bartlomiej-pluta/binary-clock/kicad/Binary Clock.kicad_pcb

## KiCad design kicad/Binary Clock.kicad_pcb (2020-12-05)

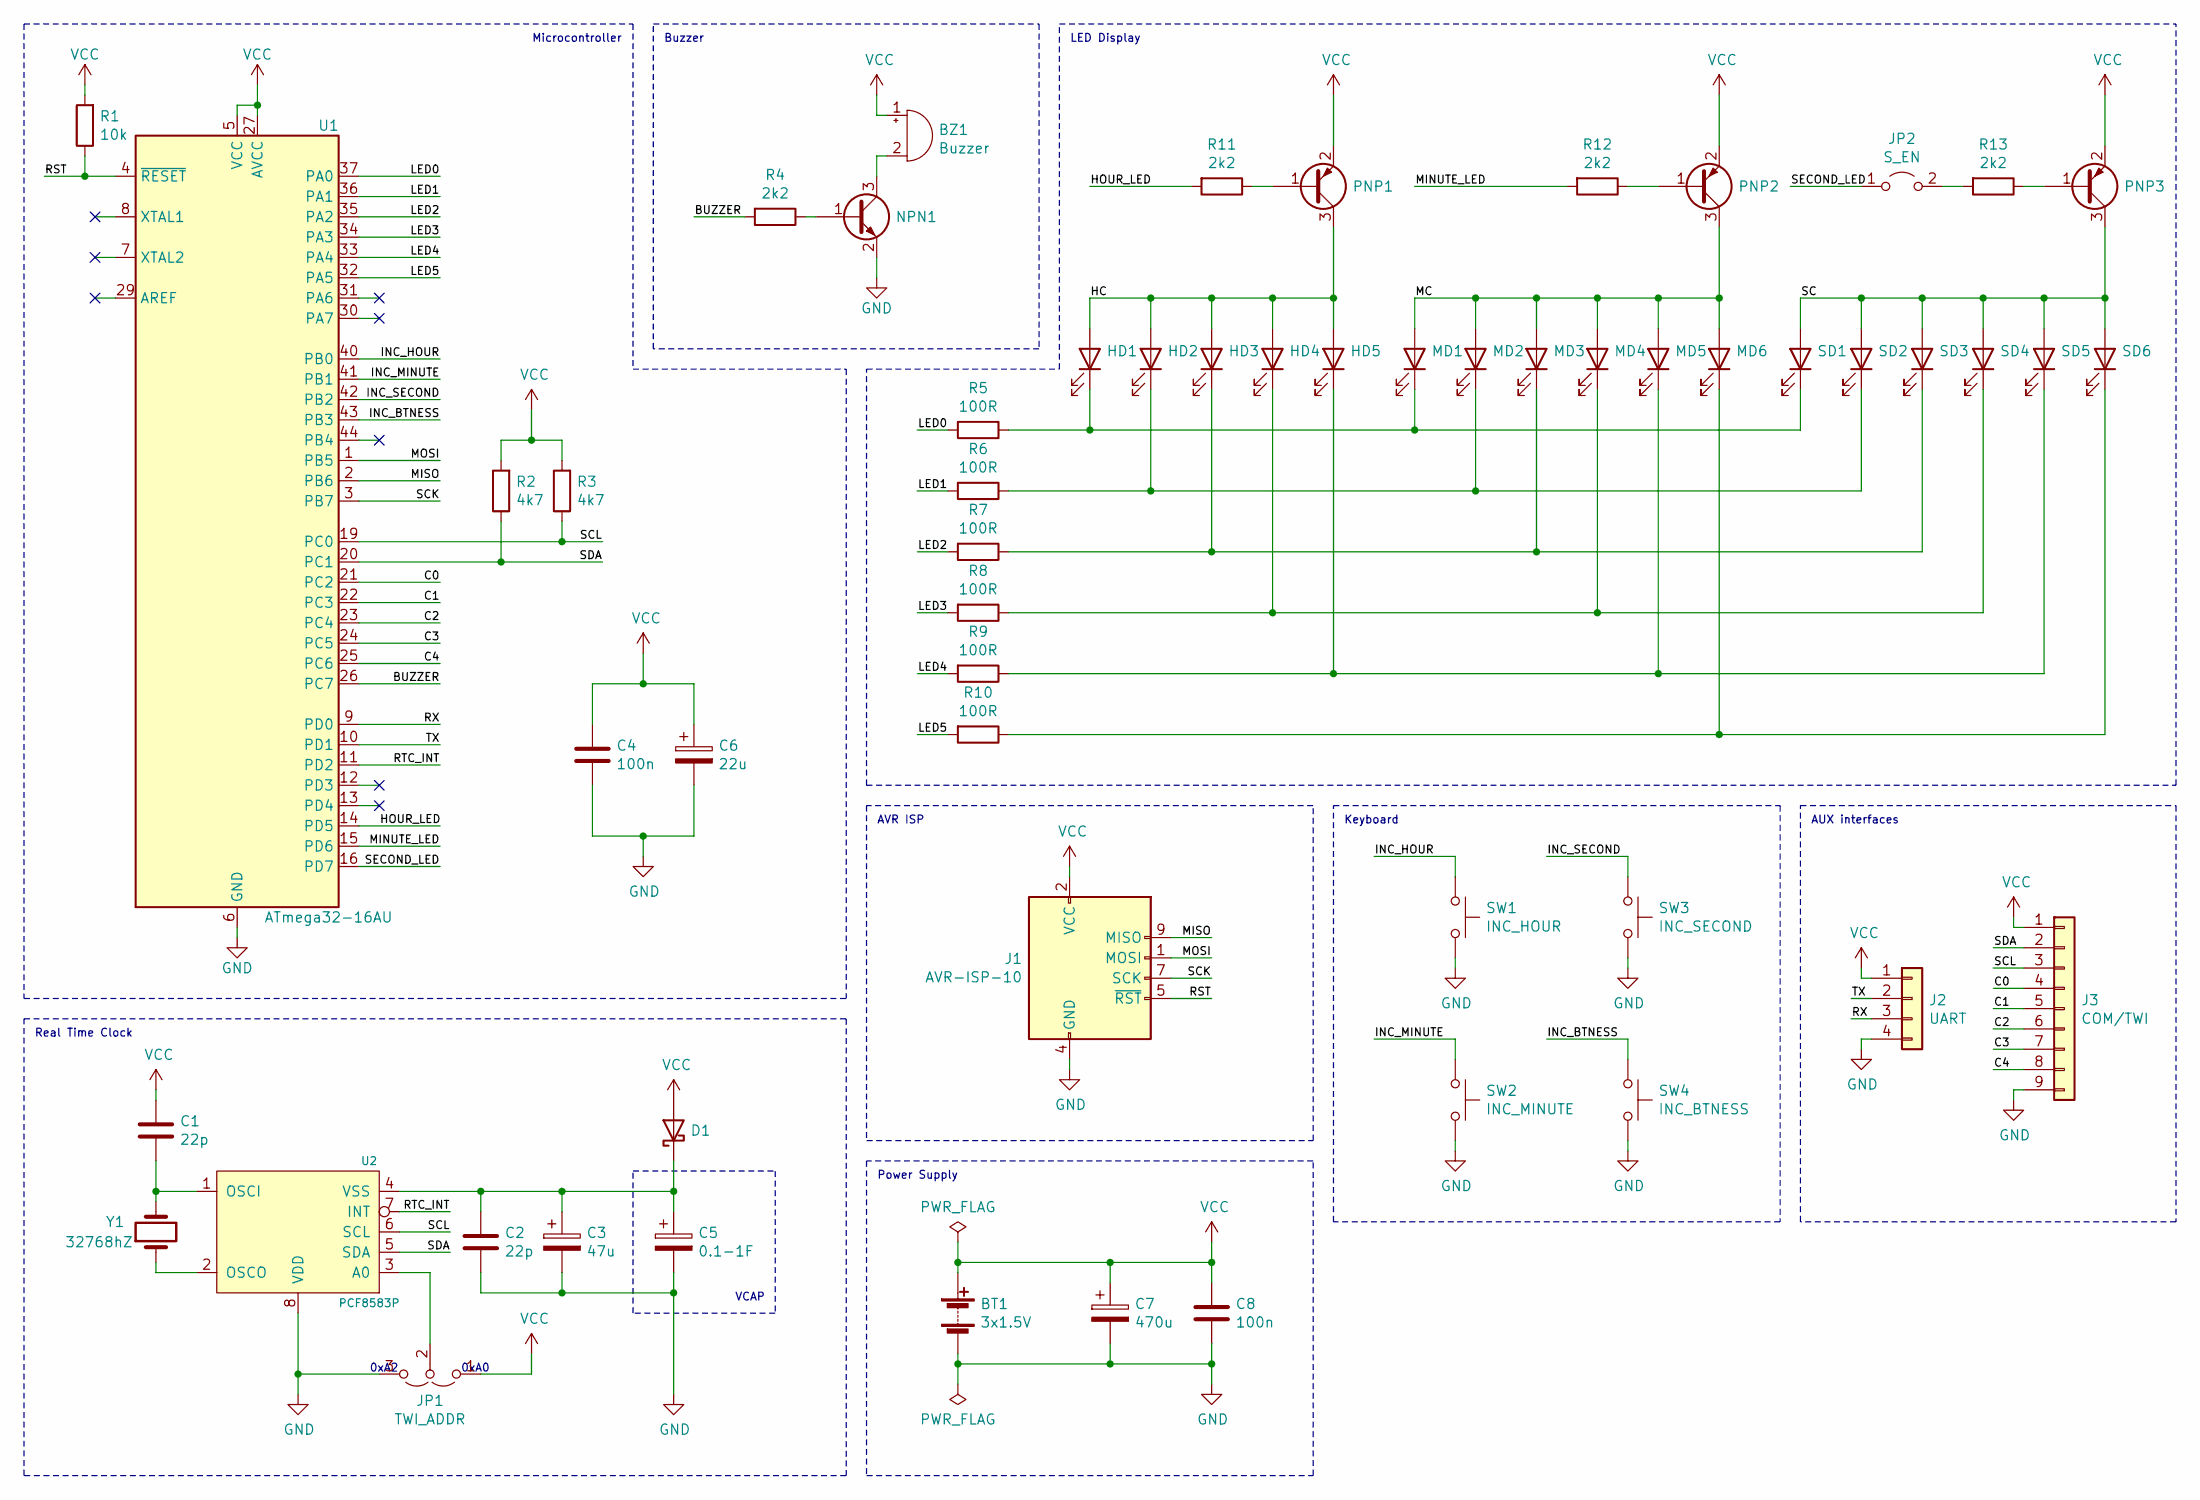
[picture p1: schematic Binary Clock.sch]

Parts:
BT1: 3x1.5V; BatteryPackage
BZ1: Buzzer; Buzzer_12x9.5RM7.6
C1, C2: 22p; C_0805_2012Metric_Pad1.18x1.45mm_HandSolder
C3: 47u; CP_Elec_6.3x5.3
C4, C8: 100n; C_0805_2012Metric_Pad1.18x1.45mm_HandSolder
C5: 0.1-1F; SuperCapacitor
C6: 22u; CP_Elec_4x3
C7: 470u; CP_Elec_8x10
D1: D_Schottky; D_2114_3652Metric
HD1, HD2, HD3, HD4, HD5: LED; LED_D5.0mm
J1: AVR-ISP-10; IDC-Header_2x05_P2.54mm_Vertical
J2: UART; PinHeader_1x04_P2.54mm_Vertical
J3: COM/TWI; PinHeader_1x09_P2.54mm_Vertical
JP1: TWI_ADDR; PinHeader_1x03_P2.54mm_Horizontal
JP2: S_EN; PinHeader_1x02_P2.54mm_Vertical
MD1, MD2, MD3, MD4, MD5, MD6: LED; LED_D5.0mm
NPN1: Q_NPN_BEC; SOT-23
PNP1, PNP2, PNP3: Q_PNP_BEC; SOT-23
R1: 10k; R_1206_3216Metric_Pad1.30x1.75mm_HandSolder
R2, R3: 4k7; R_1206_3216Metric_Pad1.30x1.75mm_HandSolder
R4, R11, R12, R13: 2k2; R_1206_3216Metric_Pad1.30x1.75mm_HandSolder
R5, R6, R7, R8, R9, R10: 100R; R_1206_3216Metric_Pad1.30x1.75mm_HandSolder
SD1, SD2, SD3, SD4, SD5, SD6: LED; LED_D5.0mm
SW1: INC_HOUR; SW_PUSH_6mm
SW2: INC_MINUTE; SW_PUSH_6mm
SW3: INC_SECOND; SW_PUSH_6mm
SW4: INC_BTNESS; SW_PUSH_6mm
U1: ATmega32-16AU; TQFP-44_10x10mm_P0.8mm
U2: PCF8583P; SOT176-1
Y1: 32768hZ; Crystal_DS26_D2.0mm_L6.0mm_Horizontal

Connections:
/BUZZER: R4.2, U1.26 (PC7)
/C0: J3.4, U1.21 (PC2)
/C1: J3.5, U1.22 (PC3)
/C2: J3.6, U1.23 (PC4)
/C3: J3.7, U1.24 (PC5)
/C4: J3.8, U1.25 (PC6)
/HC: HD1.2 (A), HD2.2 (A), HD3.2 (A), HD4.2 (A), HD5.2 (A), PNP1.3 (C)
/HOUR_LED: R11.2, U1.14 (PD5)
/INC_BTNESS: SW4.1, U1.43 (PB3)
/INC_HOUR: SW1.1, U1.40 (PB0)
/INC_MINUTE: SW2.1, U1.41 (PB1)
/INC_SECOND: SW3.1, U1.42 (PB2)
/LED0: R5.2, U1.37 (PA0)
/LED1: R6.2, U1.36 (PA1)
/LED2: R7.2, U1.35 (PA2)
/LED3: R8.2, U1.34 (PA3)
/LED4: R9.2, U1.33 (PA4)
/LED5: R10.2, U1.32 (PA5)
/MC: MD1.2 (A), MD2.2 (A), MD3.2 (A), MD4.2 (A), MD5.2 (A), MD6.2 (A), PNP2.3 (C)
/MINUTE_LED: R12.2, U1.15 (PD6)
/MISO: J1.9 (MISO), U1.2 (PB6)
/MOSI: J1.1 (MOSI), U1.1 (PB5)
/RST: J1.5 (~RST), R1.1, U1.4 (~RESET)
/RTC_INT: U1.11 (PD2), U2.7 (INT)
/RX: J2.3, U1.9 (PD0)
/SC: PNP3.3 (C), SD1.2 (A), SD2.2 (A), SD3.2 (A), SD4.2 (A), SD5.2 (A), SD6.2 (A)
/SCK: J1.7 (SCK), U1.3 (PB7)
/SCL: J3.3, R3.1, U1.19 (PC0), U2.6 (SCL)
/SDA: J3.2, R2.1, U1.20 (PC1), U2.5 (SDA)
/SECOND_LED: JP2.1 (A), U1.16 (PD7)
/TX: J2.2, U1.10 (PD1)
GND: BT1.2 (-), C2.2, C3.2, C4.2, C5.2, C6.2, C7.2, C8.2, J1.4 (GND), J1.6 (GND), J1.8 (GND), J1.10 (GND), J2.4, J3.9, JP1.3 (B), NPN1.2 (E), SW1.2, SW2.2, SW3.2, SW4.2, U1.6 (GND), U1.18 (GND), U1.28 (GND), U1.39 (GND), U2.8 (VDD)
unnamed: BZ1.2 (+), NPN1.3 (C)
unnamed: C1.2, U2.1 (OSCI), Y1.2
unnamed: C2.1, C3.1, C5.1, D1.1 (K), U2.4 (VSS)
unnamed: HD1.1 (K), MD1.1 (K), R5.1, SD1.1 (K)
unnamed: HD2.1 (K), MD2.1 (K), R6.1, SD2.1 (K)
unnamed: HD3.1 (K), MD3.1 (K), R7.1, SD3.1 (K)
unnamed: HD4.1 (K), MD4.1 (K), R8.1, SD4.1 (K)
unnamed: HD5.1 (K), MD5.1 (K), R9.1, SD5.1 (K)
unnamed: JP1.2 (C), U2.3 (A0)
unnamed: JP2.2 (B), R13.2
unnamed: MD6.1 (K), R10.1, SD6.1 (K)
unnamed: NPN1.1 (B), R4.1
unnamed: PNP1.1 (B), R11.1
unnamed: PNP2.1 (B), R12.1
unnamed: PNP3.1 (B), R13.1
unnamed: U2.2 (OSCO), Y1.1
VCC: BT1.1 (+), BZ1.1 (-), C1.1, C4.1, C6.1, C7.1, C8.1, D1.2 (A), J1.2 (VCC), J2.1, J3.1, JP1.1 (A), PNP1.2 (E), PNP2.2 (E), PNP3.2 (E), R1.2, R2.2, R3.2, U1.5 (VCC), U1.17 (VCC), U1.27 (AVCC), U1.38 (VCC)

Notes on the sheet:
VCAP
LED Display
AVR ISP
Real Time Clock
Power Supply
Keyboard
AUX interfaces
Microcontroller
Buzzer
0xA2
0xA0

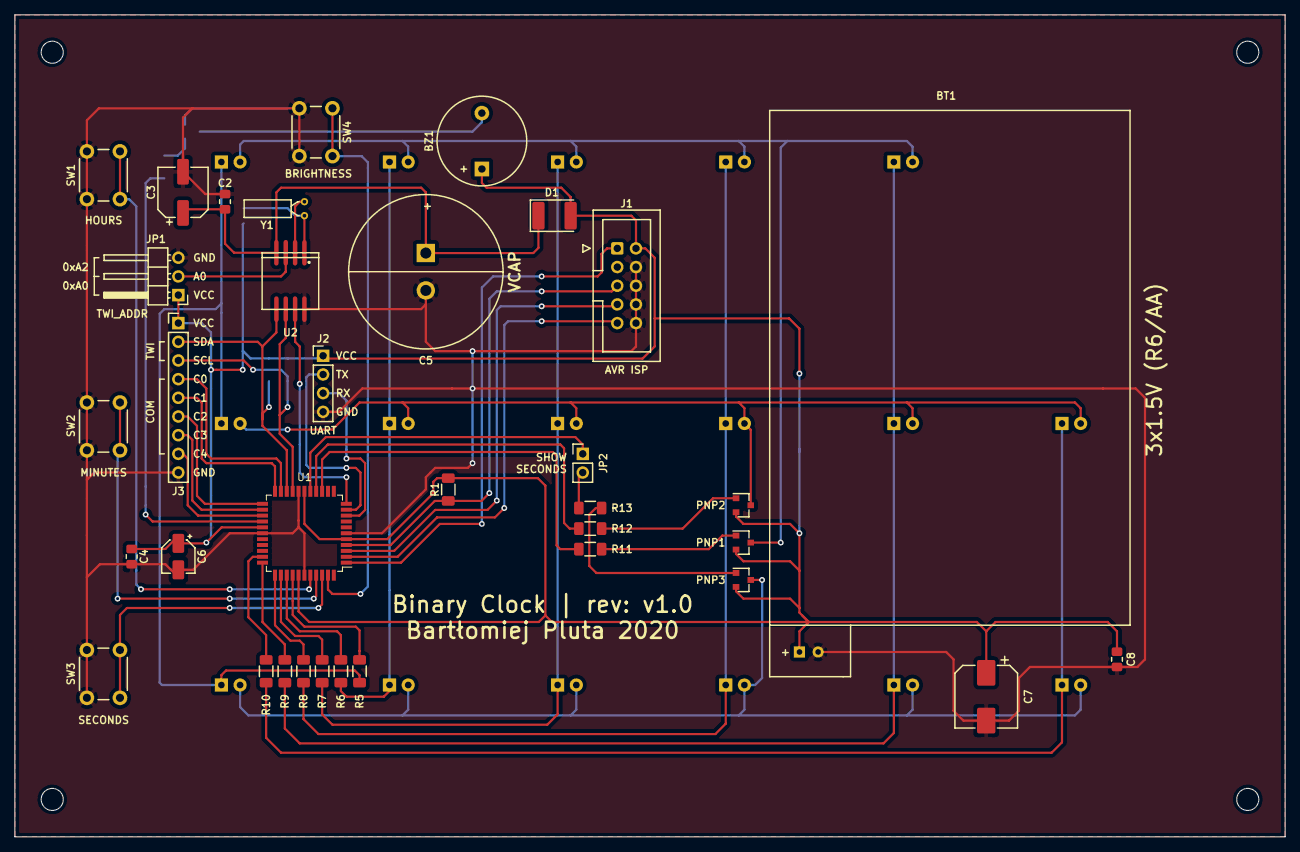
[picture p2: board Binary Clock.kicad_pcb from above]

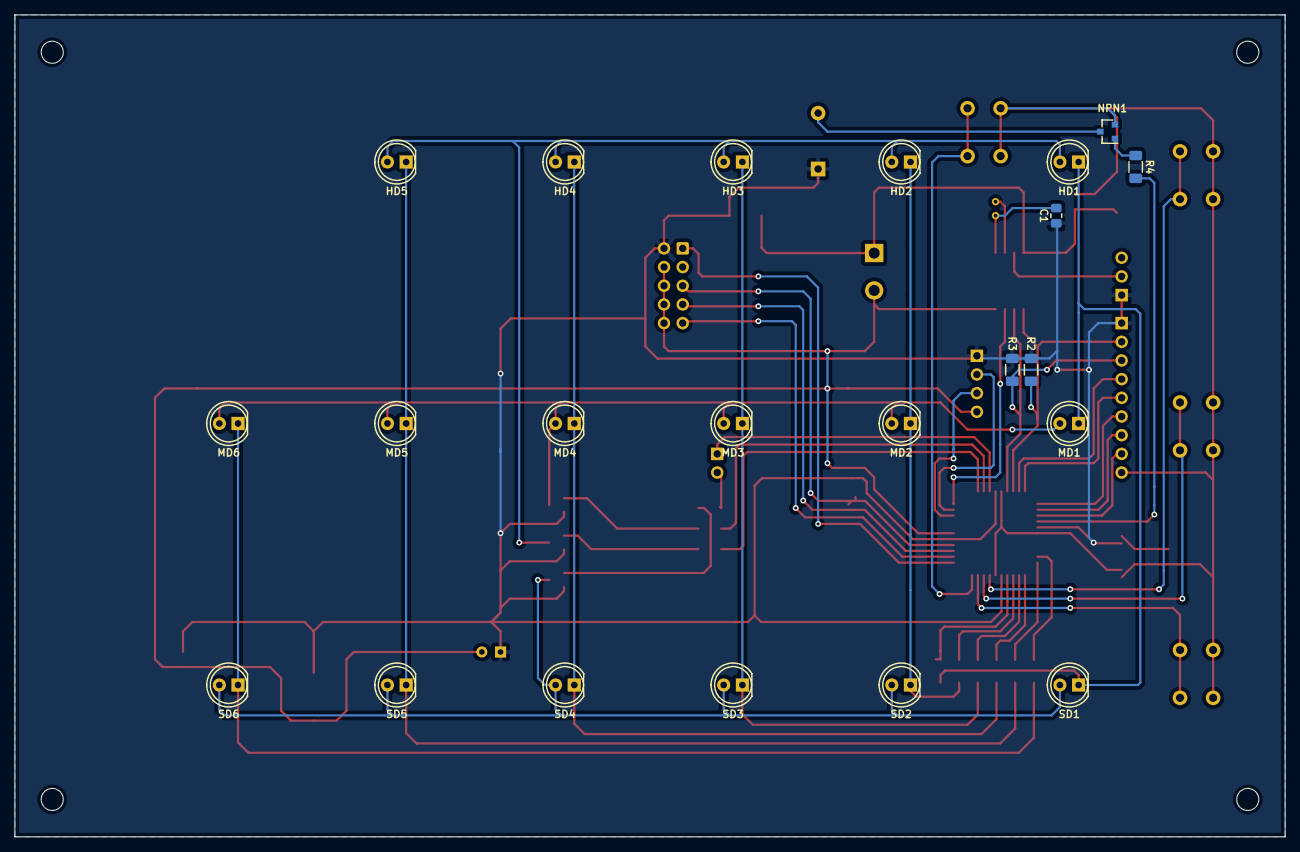
[picture p3: board Binary Clock.kicad_pcb from below]

Board: 2 copper layers, 172.7 x 111.8 mm, 57 parts (22 on the bottom side), 49 nets.
