bartlomiej-pluta/binary-clock/firmware/at.c

#include <stdlib.h>
#include <string.h>
#include <avr/version.h>
#include <avr/wdt.h>
#include <avr/pgmspace.h>
#include <avr/interrupt.h>
#include "common.h"
#include "at.h"
#include "uart.h"
#include "config.h"
#include "nightm.h"
#include "time.h"
#include "led.h"

#define PROJ_STR __PROJ_NAME__ " " __PROJ_REV__ " ::: " __PROJ_AUTHOR__ " "  __PROJ_DATE__

#define UNUSED(X) (void)(X)

int8_t cmd_at_handler(uint8_t mode, char* arg);
int8_t cmd_ati_handler(uint8_t mode, char* arg);
int8_t cmd_at_rst_handler(uint8_t mode, char* arg);
int8_t cmd_at_tim_handler(uint8_t mode, char* arg);
int8_t cmd_at_dat_handler(uint8_t mode, char* arg);
int8_t cmd_at_bts_handler(uint8_t mode, char* arg);
int8_t cmd_at_ngt_handler(uint8_t mode, char* arg);
int8_t cmd_at_buz_handler(uint8_t mode, char* arg);

#define AT_NUM 8
const struct AT_CMD at_commands[AT_NUM] PROGMEM = {
  { "AT",     cmd_at_handler     },
  { "ATI",    cmd_ati_handler    },
  { "AT+RST", cmd_at_rst_handler },
  { "AT+TIM", cmd_at_tim_handler },
  { "AT+DAT", cmd_at_dat_handler },
  { "AT+BTS", cmd_at_bts_handler },
  { "AT+NGT", cmd_at_ngt_handler },
  { "AT+BUZ", cmd_at_buz_handler }
};

static struct RTC_DATA* rtc_data;

void parse_at(char* at_cmd, char* arg, uint8_t mode)
{  
  uint8_t ok = 0;
  int8_t (*at_handler)(uint8_t mode, char* arg);
  uint8_t at_len = strlen(at_cmd);

  if(at_len)
  {
    for(uint8_t i=0; i<AT_NUM; ++i)
    {
      if(strncasecmp_P(at_cmd, at_commands[i].cmd, at_len) == 0)
      {
        at_handler = (void*) pgm_read_word(&at_commands[i].handler);
        if(at_handler)
        {          
          if(at_handler(mode, arg) >= 0) ok = 1; 
        }        
        break;
      }
    }
  }

  if(!ok) uart_puts_P(PSTR("ERROR\n\r"));
}

void at_handler(char* cmd)
{    
  if(strpbrk(cmd, "?"))
  {
    char* arg;
    char* at = strtok_r(cmd, "?", &arg);
    parse_at(at, arg, M_GET);
  }

  else if(strpbrk(cmd, "="))
  {
    char* arg;
    char* at = strtok_r(cmd, "=", &arg);
    parse_at(at, arg, M_SET);
  }

  else
  {
    parse_at(cmd, NULL, M_NORM);
  }
}

void at_update_rtc_data(struct RTC_DATA* rtc)
{
  rtc_data = rtc;
}

int8_t cmd_at_handler(uint8_t mode, char* arg)
{
  UNUSED(arg);

  if(mode != M_NORM) return -1;

  uart_puts_P(PSTR("OK\r\n"));

  return 0;
}

int8_t cmd_ati_handler(uint8_t mode, char* arg)
{
  UNUSED(arg);

  if(mode != M_NORM) return -1;

  uart_puts_P(PSTR(PROJ_STR "\r\n"));
  uart_puts_P(PSTR("compilation " __DATE__ " " __TIME__ "\n\r"));
  uart_puts_P(PSTR("avr-libc v" __AVR_LIBC_VERSION_STRING__ " " __AVR_LIBC_DATE_STRING__ "\n\r"));

  return 0;
}

int8_t cmd_at_rst_handler(uint8_t mode, char* arg)
{
  UNUSED(arg);

  if(mode != M_NORM) return -1;

  cli();
  wdt_enable(0);
  while(1);

  return 0;
}

int8_t cmd_at_tim_handler(uint8_t mode, char* arg)
{  
  struct TIME_HMS time;
  char* val;
  char* tail;

  switch(mode)
  {
    case M_GET:      
      uart_puts(rtc_data->time_str);
      uart_puts("\n\r");
      break;
    
    case M_SET:      
      if(!strlen(arg)) return -1;

      val = strtok_r(arg, ",", &tail);
      time.hour = atoi(val);
      if(time.hour >= 24) return -1;

      val = strtok_r(NULL, ",", &tail);
      time.minute = atoi(val);
      if(time.minute >= 60) return -1;

      val = strtok_r(NULL, ",", &tail);
      time.second = atoi(val);
      if(time.second >= 60) return -1;

      rtc_set_time(&time);

      uart_puts_P(PSTR("+TIM="));
      uart_puti(time.hour, 10);
      uart_putc(',');
      uart_puti(time.minute, 10);
      uart_putc(',');
      uart_puti(time.second, 10);
      uart_puts("\n\r");
      break;

    case M_NORM:
      uart_puts_P(PSTR("AT+TIM=(0-23),(0-59),(0-59)\r\n"));
  }

  return 0;
}

int8_t cmd_at_dat_handler(uint8_t mode, char* arg)
{
  struct DATE_YMD date;
  char* val;
  char* tail;

  switch(mode)
  {
    case M_GET:      
      uart_puts(rtc_data->date_str);
      uart_putc(' ');
      uart_puts(rtc_data->weekday_str);
      uart_puts("\n\r");
      break;
    
    case M_SET:      
      if(!strlen(arg)) return -1;

      val = strtok_r(arg, ",", &tail);
      date.day = atoi(val);
      if(date.day < 1 || 31 < date.day) return -1;

      val = strtok_r(NULL, ",", &tail);
      date.month = atoi(val);
      if(date.month < 1 || 12 < date.month) return -1;

      val = strtok_r(NULL, ",", &tail);
      date.year = atoi(val);            

      rtc_set_date(&date);

      uart_puts_P(PSTR("+DAT="));
      uart_puti(date.day, 10);
      uart_putc(',');
      uart_puti(date.month, 10);
      uart_putc(',');
      uart_puti(date.year, 10);
      uart_puts("\n\r");
      break;

    case M_NORM:
      uart_puts_P(PSTR("AT+DAT=(1-31),(1-12),(0-65535)\r\n"));
  }


  return 0;
}

int8_t cmd_at_bts_handler(uint8_t mode, char* arg)
{
  uint8_t btnes;

  switch(mode)
  {
    case M_GET:    
      uart_puti(ram_cfg.led_btnes, 10);
      uart_puts("\n\r");

      break;
    
    case M_SET:
      if(!strlen(arg)) return -1;

      btnes = atoi(arg);
      if(btnes >= 8) return -1;      
      led_set_btnes(ram_cfg.led_btnes = btnes);
      dump_ram2eem();

      uart_puts_P(PSTR("+BTS="));
      uart_puts(arg);
      uart_puts("\n\r");

      break;

    case M_NORM:
      uart_puts_P(PSTR("AT+BTS=(0-7)\n\r"));
  }

  return 0;
}

int8_t cmd_at_ngt_handler(uint8_t mode, char* arg)
{
  struct NIGHTM_CFG nightm_cfg;
  char* val;
  char* tail;

  switch(mode)
  {
    case M_GET:
      uart_puti(ram_cfg.night_mode.led_btnes, 10);
      uart_puts_P(ram_cfg.night_mode.led_btnes >= 0 ? PSTR(" (EN)\n\r") : PSTR(" (DIS)\n\r"));
      uart_puti(ram_cfg.night_mode.begin.hour, 10);
      uart_puts(":");
      uart_puti(ram_cfg.night_mode.begin.minute, 10);
      uart_puts("\n\r");
      uart_puti(ram_cfg.night_mode.end.hour, 10);
      uart_puts(":");
      uart_puti(ram_cfg.night_mode.end.minute, 10);
      uart_puts("\n\r");
      break;
    
    case M_SET:
      if(!strlen(arg)) return -1;

      val = strtok_r(arg, ",", &tail);
      nightm_cfg.led_btnes = atoi(val);
      if(nightm_cfg.led_btnes < -1 && 7 < nightm_cfg.led_btnes) return -1;

      val = strtok_r(NULL, ",", &tail);
      nightm_cfg.begin.hour = atoi(val);
      if(nightm_cfg.begin.hour > 23) return -1;

      val = strtok_r(NULL, ",", &tail);
      nightm_cfg.begin.minute = atoi(val);
      if(nightm_cfg.begin.minute > 59) return -1;

      val = strtok_r(NULL, ",", &tail);
      nightm_cfg.end.hour = atoi(val);
      if(nightm_cfg.end.hour > 23) return -1;

      val = strtok_r(NULL, ",", &tail);
      nightm_cfg.end.minute = atoi(val);
      if(nightm_cfg.end.minute > 59) return -1;

      nightm_config(&nightm_cfg);
      dump_ram2eem();

      uart_puts_P(PSTR("+NGT="));
      uart_puti(nightm_cfg.led_btnes, 10);
      uart_puts(",");
      uart_puti(nightm_cfg.begin.hour, 10);
      uart_puts(",");
      uart_puti(nightm_cfg.begin.minute, 10);
      uart_puts(",");
      uart_puti(nightm_cfg.end.hour, 10);
      uart_puts(",");
      uart_puti(nightm_cfg.end.minute, 10);
      uart_puts("\n\r");
      break;

    case M_NORM:
      uart_puts_P(PSTR("AT+NGT=(-1|0-7),(0-23),(0-59),(0-23),(0-59)\n\r"));
  }

  return 0;
}

int8_t cmd_at_buz_handler(uint8_t mode, char* arg)
{       
  uint8_t buz_en;

  switch(mode)
  {
    case M_GET:
      uart_puti(ram_cfg.buz_en, 10);
      uart_puts("\n\r");
      break;

    case M_SET:
      if(!strlen(arg)) return -1;
      
      buz_en = atoi(arg);
      if(buz_en != 0 && buz_en != 1) return -1;
      ram_cfg.buz_en = buz_en;
      dump_ram2eem();
      uart_puts_P(PSTR("+BUZ="));
      uart_puti(buz_en, 10);
      uart_puts("\n\r");
      break;

    case M_NORM:
      uart_puts_P(PSTR("AT+BUZ=(0|1)\n\r"));
  }

  return 0;
}
