bartlomiej-pluta/binary-clock/firmware/uart.c

#include <avr/io.h>
#include <avr/interrupt.h>
#include <avr/pgmspace.h>
#include <stdlib.h>
#include "uart.h"

// Ring buffer macros
#define RBUF(BUF_SIZE) struct { char data[BUF_SIZE]; uint8_t head; uint8_t tail; }
#define RBUF_NEXT(BUF_IDX, MOD_MASK) (((BUF_IDX) + 1) & MOD_MASK)
#define RBUF_FORWARD(BUF_IDX, MOD_MASK) BUF_IDX = RBUF_NEXT(BUF_IDX, MOD_MASK)
#define RBUF_EMPTY(BUFF) (BUFF.head == BUFF.tail)

#define CR 0x0D
#define LF 0x0A

volatile RBUF(UART_RX_BUF_SIZE) rx_buffer;
volatile RBUF(UART_TX_BUF_SIZE) tx_buffer;

volatile uint8_t lines = 0;
void (*uart_handler)(char* line);

void uart_init(void)
{
	UBRRH = (uint8_t) (__UBRR>>8);
	UBRRL = (uint8_t) __UBRR;

	UCSRB = (1<<RXEN) | (1<<TXEN) | (1<<RXCIE);
	UCSRC = (1<<URSEL) | (3<<UCSZ0);
}

void uart_putc(char data)
{
	uint8_t head = RBUF_NEXT(tx_buffer.head, UART_TX_BUF_MASK);

  while(head == tx_buffer.tail);

  tx_buffer.data[head] = data;
  tx_buffer.head = head;

  UCSRB |= (1<<UDRIE);
}

void uart_puts(char* str)
{
  register char c;
  while ((c = *str++)) uart_putc(c);
}

void uart_puts_P(const char *str)
{
  register char c;
  while ((c = pgm_read_byte(str++))) uart_putc(c);  
}

void uart_puti(int16_t value, int16_t radix)
{
	char number[20];
	itoa(value, number, radix);
	uart_puts(number);
}

char uart_getc(void)
{
  if(RBUF_EMPTY(rx_buffer)) return -1;
  RBUF_FORWARD(rx_buffer.tail, UART_RX_BUF_MASK);
  return rx_buffer.data[rx_buffer.tail];
}

void uart_gets(char* buf)
{
  char c;

  if(lines)
  {
    while((c = uart_getc()))
    {
      if(c == CR || c < 0) break;
      *buf++ = c;
    }

    *buf = 0;
    --lines;
  }
}

void uart_bind_handler(void (*handler)(char* line))
{
  uart_handler = handler;
}

void uart_handle_event(char* buf)
{
  if(lines)
  {
    if(uart_handler)
    {
      uart_gets(buf);
      (*uart_handler)(buf);
    }
  }
}

ISR(USART_UDRE_vect)
{    
  if(!RBUF_EMPTY(tx_buffer)) 
	{
    RBUF_FORWARD(tx_buffer.tail, UART_TX_BUF_MASK);
    UDR = tx_buffer.data[tx_buffer.tail];
  } 
	else 
	{
		UCSRB &= ~(1<<UDRIE);
  }
}

ISR(USART_RXC_vect)
{  
  register uint8_t head = RBUF_NEXT(rx_buffer.head, UART_RX_BUF_MASK);
  register char data = UDR;

  if(head == rx_buffer.tail)
  {
    rx_buffer.head = rx_buffer.tail;
  }
  else switch(data)
  {
    case 0: case LF: break;
    case CR: ++lines;
    default: 
      rx_buffer.head = head;
      rx_buffer.data[head] = data;
  }
}
