bartlomiej-pluta/binary-clock/(commit log)

2020-11-08 Create library for managing LED binary display
2020-11-08 Create I2C/TWI library and enable it
2020-11-09 Create library for software timers and enable it
2020-11-13 Create KiCAD project
    [Binary Clock.kicad_pcb, Binary Clock.sch]
2020-11-17 Enable software-based LED brightness configuration
2020-11-17 Enable storing LED brightness in EEPROM
2020-11-18 Replace led_hour (etc.) globals with TIME struct
    [keyboard.c, led.c, led.h, main.c, rtc.h, time.h]
2020-11-18 Add INC_BTNESS button to schema
    INC_BTNESS button is desired to increment LED display brightness
    [Binary Clock.sch]
2020-11-18 Add INC_BTNESS button to PCB
    [Binary Clock.kicad_pcb]
2020-11-18 Create simple UART library
2020-11-18 Enable callbacks and CR separator in UART library
2020-11-19 Create UART-based AT commands library
2020-11-19 Update schema and PCB design
    [Binary Clock.kicad_pcb, Binary Clock.sch]
2020-11-22 Fix warnings in RTC module
    [rtc.c]
2020-11-23 Add support for buzzer
    [Binary Clock.kicad_pcb, Binary Clock.sch]
2020-11-24 Change goldpins to 2.56mm
    [Binary Clock.kicad_pcb, Binary Clock.sch]
2020-12-03 Update PCB footprints
    [Binary Clock.kicad_pcb, Binary Clock.sch]
2020-12-03 Fix some issues on PCB
    [Binary Clock.kicad_pcb, Binary Clock.sch]
2020-12-05 Fix some issues and text labels on PCB
    [Binary Clock.kicad_pcb]
2020-12-05 Fix invalid ATmega footprint
    [Binary Clock.kicad_pcb, Binary Clock.sch]
2020-12-05 Improve schema
    [Binary Clock.kicad_pcb, Binary Clock.sch]
